Tomdf/Milli_Matrix_v2/README.md

Mini_Matrix_v2
==============

Hardware and software for the Mini-Matrix v2
