Tomdf/Milli_Matrix_v2/Hardware/Milli_Matrix_v2_sch.pdf

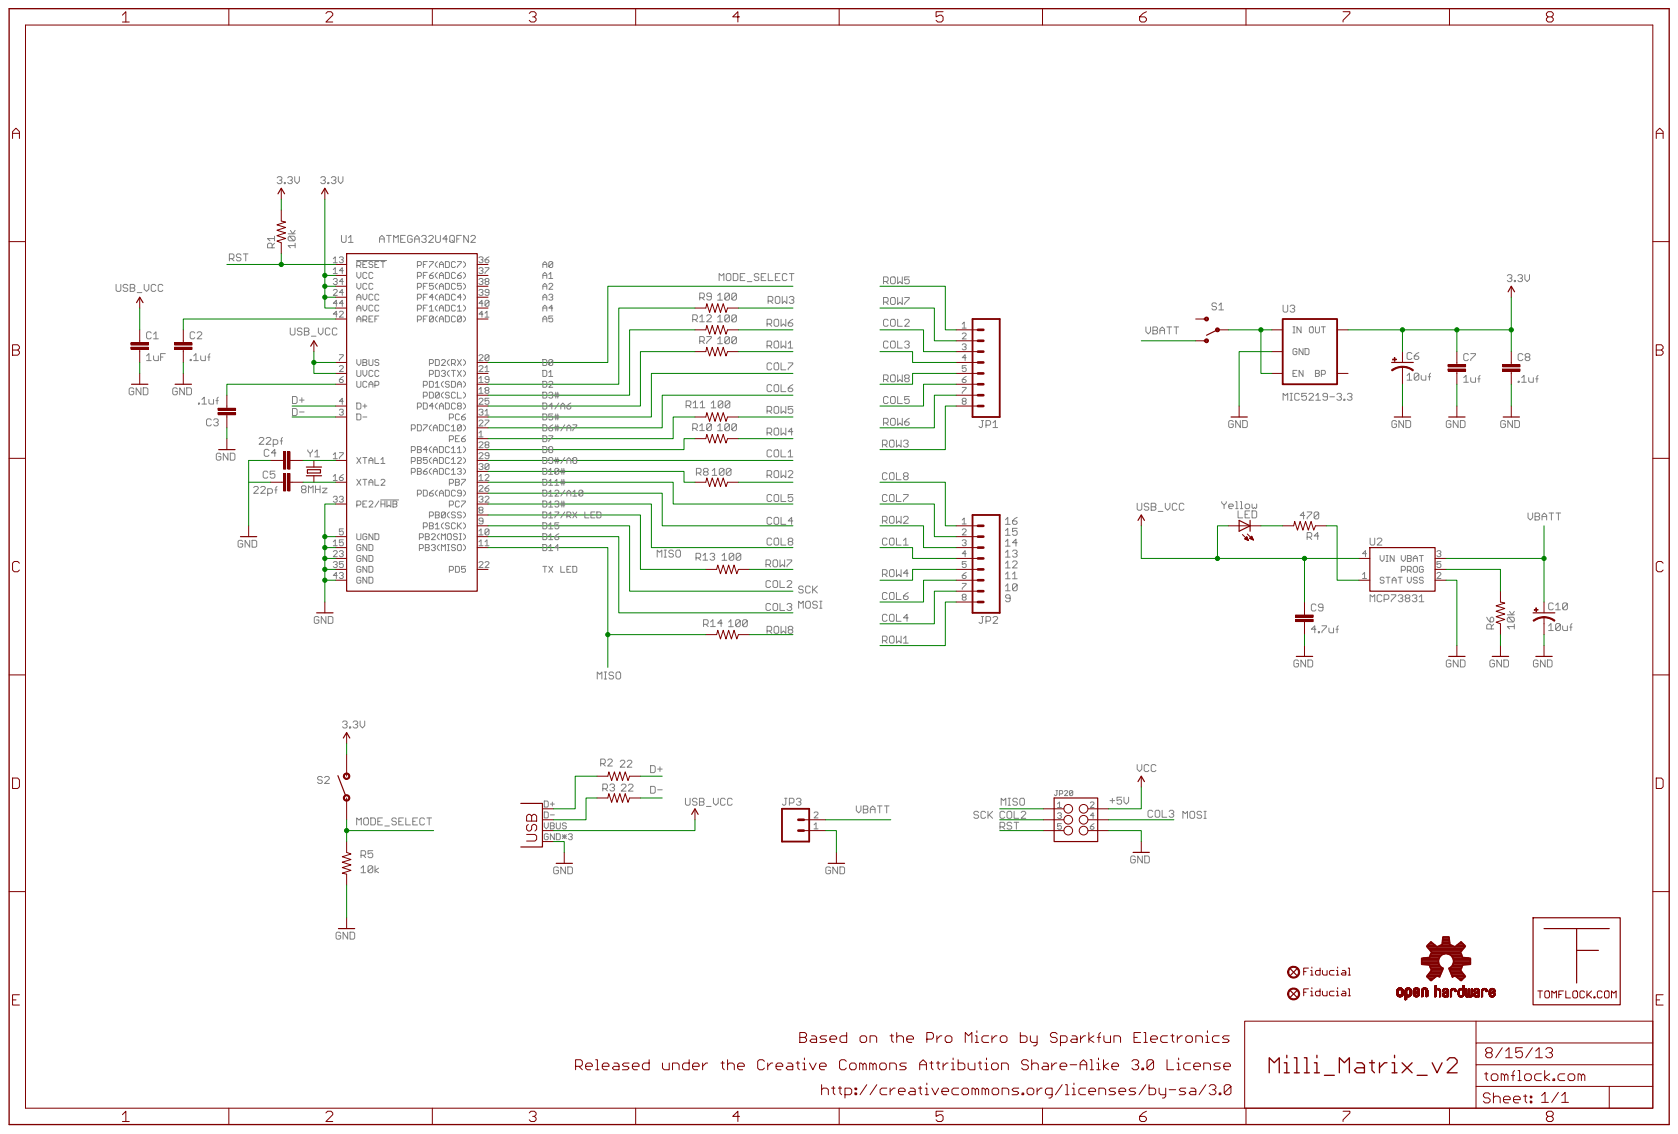
[picture p1: page 1]
