Tomdf/Milli_Matrix_v2/Hardware/Milli_Matrix_v2.sch

## EAGLE design Hardware/Milli_Matrix_v2.sch (2013-08-22)

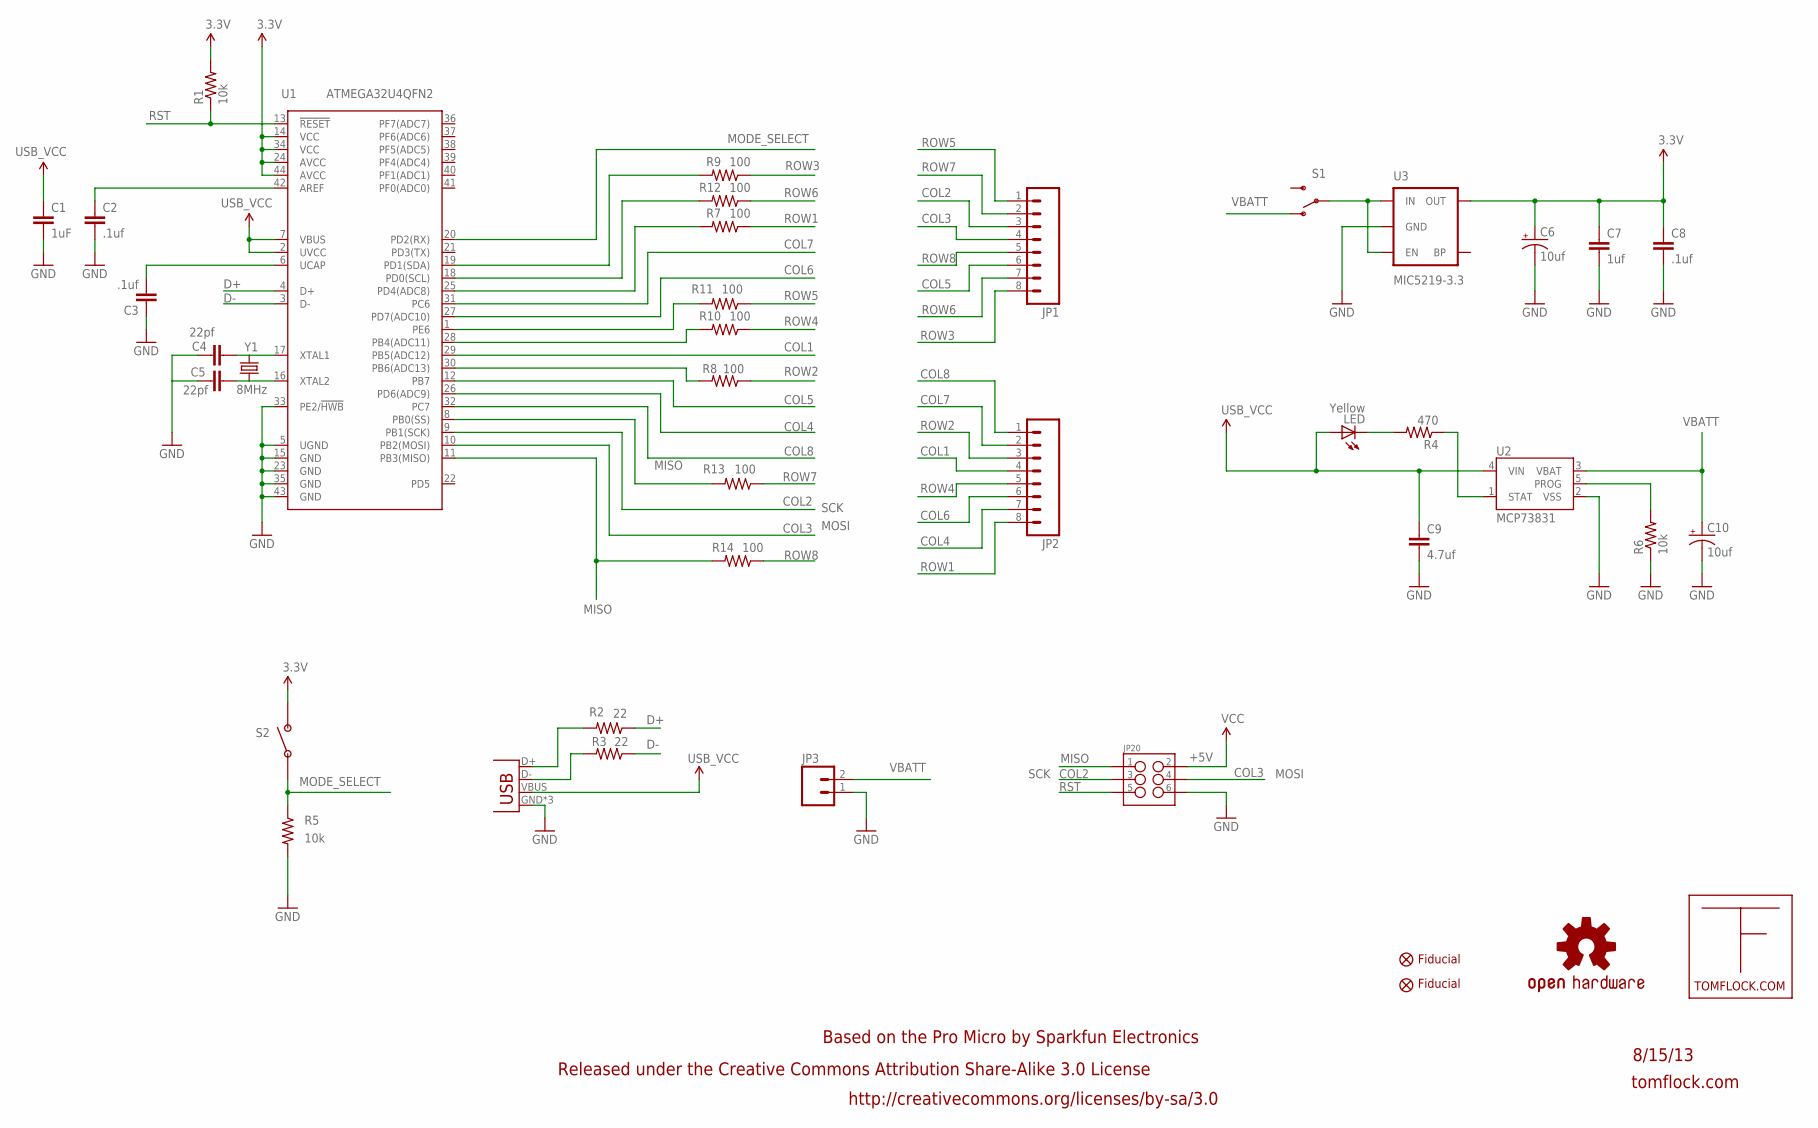
[picture p2: schematic Milli_Matrix_v2.sch]

Parts:
C1: 1uF; 0402-CAP
C2, C3, C8: .1uf; 0402-CAP
C4, C5: 22pf; 0402-CAP
C6, C10: 10uf; EIA3216
C7: 1uf; 0402-CAP
C9: 4.7uf; 0402-CAP
JP1, JP2: M08SMD-STRAIGHT; 1X08_SMD
JP3: M02-JST-2-PTH-NO_SILK; JST-2-PTH-NS
JP6, JP7: FIDUCIAL1X2; FIDUCIAL-1X2
JP20: M03X22X3_SILK_SM; 2X3
LED: Yellow; LED-0603
R1, R5, R6: 10k; 0402-RES
R2, R3: 22; 0402-RES
R4: 470; 0402-RES
R7, R8, R9, R10, R11, R12, R13, R14: 100; 0402-RES
S1: SWITCH-SPST-SMD-A
S2: SWITCH-RIGHT-ANGLE-SMD
U1: ATMEGA32U4QFN2; SPARKFUN-DIGITALIC_QFN-44-NOPAD
U2: MCP73831; SOT23-5
U3: MIC5219-3.3; SOT23-5
U$1: TFLOGO
U$2: OSHW-LOGOS; OSHW-LOGO-S
USB_MICROB: USB-MICROB
Y1: 8MHz; CRYSTAL-SMD-5X3

Connections:
3.3V: C6.A (+), C7.1, C8.1, JP20.2, R1.2, S2.2, U1.14 (VCC), U1.24 (AVCC), U1.34 (VCC), U1.44 (AVCC), U3.5 (OUT)
COL1: JP2.4, U1.29 (PB5(ADC12))
COL2: JP1.3, JP20.3, U1.9 (PB1(SCK))
COL3: JP1.4, JP20.4, U1.10 (PB2(MOSI))
COL4: JP2.7, U1.26 (PD6(ADC9))
COL5: JP1.6, U1.12 (PB7)
COL6: JP2.6, U1.27 (PD7(ADC10))
COL7: JP2.2, U1.31 (PC6)
COL8: JP2.1, U1.32 (PC7)
D+: R2.1, U1.4 (D+)
D-: R3.1, U1.3 (D-)
GND: C1.2, C2.2, C3.1, C4.1, C5.1, C6.C (-), C7.2, C8.2, C9.2, C10.C (-), JP3.1, JP20.6, R5.2, R6.1, U1.5 (UGND), U1.15 (GND), U1.23 (GND), U1.33 (PE2/!HWB), U1.35 (GND), U1.43 (GND), U2.2 (VSS), U3.2 (GND), USB_MICROB.GND
MISO: JP20.1, R14.2, U1.11 (PB3(MISO))
MODE_SELECT: R5.1, S2.1, U1.20 (PD2(RX))
unnamed: S1.2, U3.1 (IN), U3.3 (EN)
unnamed: C5.2, U1.16 (XTAL2), Y1.1
unnamed: R6.2, U2.5 (PROG)
unnamed: C4.2, U1.17 (XTAL1), Y1.3 (2)
unnamed: C2.1, U1.42 (AREF)
unnamed: R4.1, U2.1 (STAT)
unnamed: LED.C, R4.2
unnamed: C3.2, U1.6 (UCAP)
unnamed: R11.2, U1.1 (PE6)
unnamed: R13.2, U1.8 (PB0(SS))
unnamed: R12.2, U1.18 (PD0(SCL))
unnamed: R9.2, U1.19 (PD1(SDA))
unnamed: R3.2, USB_MICROB.D-
unnamed: R2.2, USB_MICROB.D+
unnamed: R8.2, U1.30 (PB6(ADC13))
unnamed: R10.2, U1.28 (PB4(ADC11))
unnamed: R7.2, U1.25 (PD4(ADC8))
ROW1: JP2.8, R7.1
ROW2: JP2.3, R8.1
ROW3: JP1.8, R9.1
ROW4: JP2.5, R10.1
ROW5: JP1.1, R11.1
ROW6: JP1.7, R12.1
ROW7: JP1.2, R13.1
ROW8: JP1.5, R14.1
RST: JP20.5, R1.1, U1.13 (!RESET)
VBATT: C10.A (+), JP3.2, S1.1 (O), U2.3 (VBAT)
VCC: C1.1, C9.1, LED.A, U1.2 (UVCC), U1.7 (VBUS), U2.4 (VIN), USB_MICROB.VBUS

Notes on the sheet:
SCK
MOSI
+5V
Released under the Creative Commons Attribution Share-Alike 3.0 License
http://creativecommons.org/licenses/by-sa/3.0
tomflock.com
8/15/13
Based on the Pro Micro by Sparkfun Electronics
Fiducial
