Tomdf/Milli_Matrix_v2/Firmware/Installing Bootloader on 32u4.txt

How to Burn the Bootloader to the milliMATRIX v2
Hardware: AVR Pocket Programmer
Software: AVRDUDE
8/28/13

1. Visit the SparkFun Github and download the "SF32u4_boards-master" folder

2. navigate to the folder /SF32u4_boards-master/bootloaders/caterina

3. Open the "program.txt" file

4. under "promicro8" change the efuse to 0xce

5. save the file as "program.bat"

6. rename the file "build.txt" to "build.bat". The entire line will read as such:
IF "%1"=="promicro8" avrdude -p m32u4 -P usb -c usbtiny -U flash:w:Caterina-promicro8.hex -U efuse:w:0xce:m -U hfuse:w:0xd8:m -U lfuse:w:0xff:m

7. Google for LUFA-111009, download it, and paste it into the 
	bootloaders/caterina folder
	
8. Connect the AVR Pocket Programmer to usb and to the milliMATRIX.
	
9. Run "program.bat", you can double-click the icon.

10. If all goes well the board will be programmed and when it is plugged in it
	should show up in device manager and arduino ide as pro micro 8
