Tomdf/Milli_Matrix_v2/Arduino/Milli_Matrix___MRSKULL/milliMATRIX_Definitions.h

/* 
  Pattern Definitions for milliMatrix
  Alphabet
  Numbers
  Heart
  Invaders
  MrSkull
  8-26-13
*/ 

#define A { \
    {0, 0, 0, 1, 1, 0, 0, 0}, \
    {0, 0, 1, 0, 0, 1, 0, 0}, \
    {0, 1, 0, 0, 0, 0, 1, 0}, \
    {0, 1, 0, 0, 0, 0, 1, 0}, \
    {0, 1, 1, 1, 1, 1, 1, 0}, \
    {0, 1, 0, 0, 0, 0, 1, 0}, \
    {0, 1, 0, 0, 0, 0, 1, 0}, \
    {0, 1, 0, 0, 0, 0, 1, 0}  \
}

#define B { \
    {0, 1, 1, 1, 1, 1, 0, 0}, \
    {0, 1, 0, 0, 0, 0, 1, 0}, \
    {0, 1, 0, 0, 0, 0, 1, 0}, \
    {0, 1, 1, 1, 1, 1, 0, 0}, \
    {0, 1, 0, 0, 0, 0, 1, 0}, \
    {0, 1, 0, 0, 0, 0, 1, 0}, \
    {0, 1, 0, 0, 0, 0, 1, 0}, \
    {0, 1, 1, 1, 1, 1, 0, 0}  \
}

#define C { \
    {0, 0, 1, 1, 1, 1, 0, 0}, \
    {0, 1, 0, 0, 0, 0, 1, 0}, \
    {0, 1, 0, 0, 0, 0, 1, 0}, \
    {0, 1, 0, 0, 0, 0, 0, 0}, \
    {0, 1, 0, 0, 0, 0, 0, 0}, \
    {0, 1, 0, 0, 0, 0, 1, 0}, \
    {0, 1, 0, 0, 0, 0, 1, 0}, \
    {0, 0, 1, 1, 1, 1, 0, 0}  \
}

#define D { \
    {0, 1, 1, 1, 1, 0, 0, 0}, \
    {0, 1, 0, 0, 0, 1, 0, 0}, \
    {0, 1, 0, 0, 0, 0, 1, 0}, \
    {0, 1, 0, 0, 0, 0, 1, 0}, \
    {0, 1, 0, 0, 0, 0, 1, 0}, \
    {0, 1, 0, 0, 0, 0, 1, 0}, \
    {0, 1, 0, 0, 0, 1, 0, 0}, \
    {0, 1, 1, 1, 1, 0, 0, 0}  \
}

#define E { \
    {0, 1, 1, 1, 1, 1, 1, 0}, \
    {0, 1, 0, 0, 0, 0, 0, 0}, \
    {0, 1, 0, 0, 0, 0, 0, 0}, \
    {0, 1, 1, 1, 1, 1, 0, 0}, \
    {0, 1, 0, 0, 0, 0, 0, 0}, \
    {0, 1, 0, 0, 0, 0, 0, 0}, \
    {0, 1, 0, 0, 0, 0, 0, 0}, \
    {0, 1, 1, 1, 1, 1, 1, 0}  \
}

#define F { \
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
}

#define MRSKULL9 { \
    {0, 0, 1, 1, 1, 1, 1, 0}, \
    {0, 1, 1, 1, 1, 1, 1, 1}, \
    {1, 0, 0, 0, 0, 0, 1, 1}, \
    {1, 0, 1, 1, 0, 1, 1, 1}, \
    {0, 1, 1, 0, 1, 1, 1, 0}, \
    {0, 0, 0, 1, 1, 1, 0, 0}, \
    {0, 0, 0, 0, 1, 1, 0, 0}, \
    {0, 0, 0, 1, 1, 1, 0, 0}  \
}
