Tomdf/Milli_Matrix_v2/(commit log)

2013-08-12 Initial Commit
    EaglePCB schematic and board files
    [Mini_Matrix_v2.brd, Mini_Matrix_v2.sch]
2013-08-16 Added detailed Documentation
    Assembly Drawing
    Schematic
    Stencil
    [Mini_Matrix_v2.sch]
2013-08-16 Schematic Cleanup
    Tweaked the schematic layout for aesthetics and reason.
2013-08-17 LED DataSheet and Bootloader Instructions
2013-08-19 Rename and Arduino Code
    Got matrix work good, tired
    sleep good
    ss==
    [Milli_Matrix_v2.brd, Milli_Matrix_v2.sch]
2013-08-20 Updates to Arduino Code
    Set up a definitions file for the MRSKULL pattern arrays.
    Added a second mode, although I forget the name.. Biting Skull?
    Whatever, it is two frames, one with the mouth open and the other with
    mouth closed.
    Played around with the brightness by removing the delay for blank pixels
    (so that ON pixels were ON more ONften. Then set the leds to stay lit
    longer. This all worked so now it's time to test the battery life at
    this increased brightness level.
    Again, I'm pretty exhausted after spending another night grinding away
    on matrixes. It is definately time for a break and some extended periods
    of sleep time goodness. Wild Stallions Rule!!
2013-08-22 PCB Cleanup + back solder pads for mounting
    Tweaked some of the component placements
    Put some rectangles on the back of the board in hopes of soldering
    safety pins to them.
    [Milli_Matrix_v2.sch]
2013-08-26 Adjusted definitions.h
    Renamed the definitions.h file from MRSKULL to millMATRIX.
    Cleaned up the "firmware" burning instructions.
    [milliMATRIX_Definitions.h]
2013-08-27 New Animations Sketch
    Started a new sketch for different sets of two frame animations. Biting
    skull, and two invaders
